satvikg-andrew/AirCube/AirCube_finalized/AirCube_revised/review/JLC3313-user-calculator.png

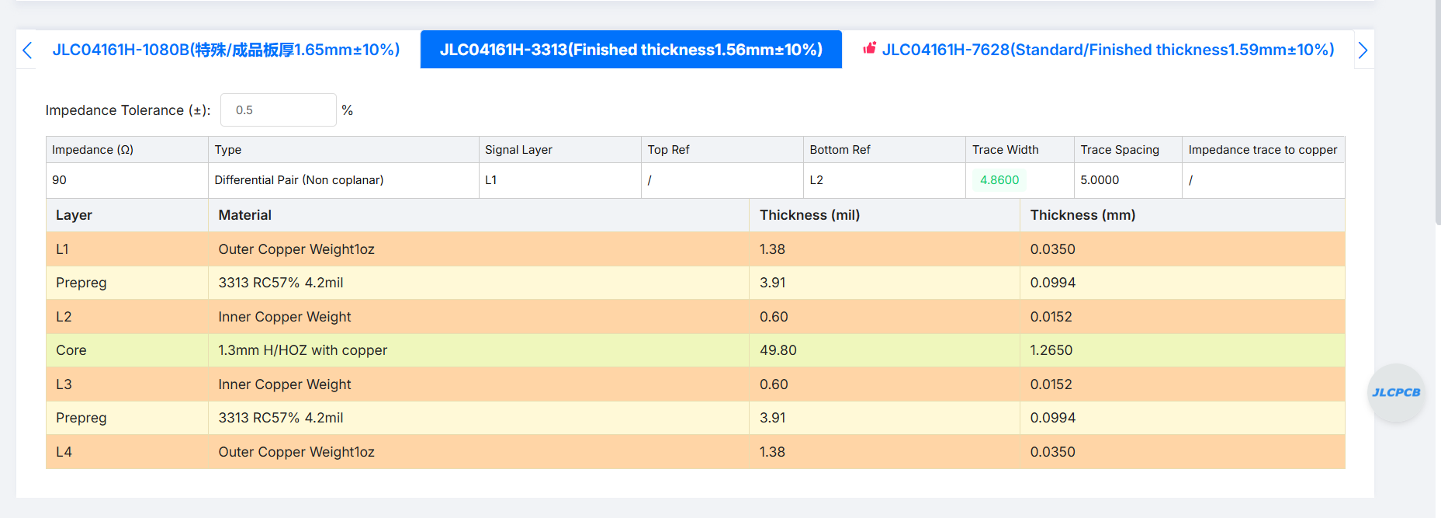
AirCube_finalized/AirCube_revised/review/JLC3313-user-calculator.png
