satvikg-andrew/AirCube/AirCube_finalized/AirCube_revised/review/plots/AirCube-B_Cu.png

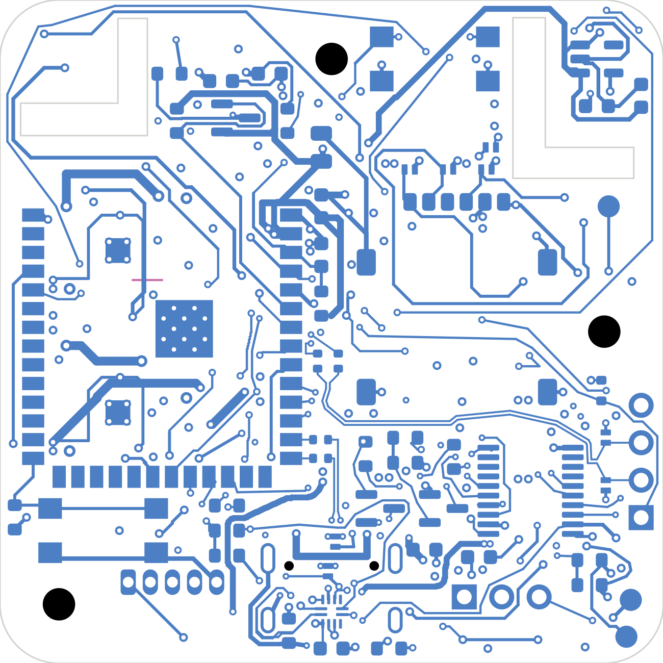
AirCube_finalized/AirCube_revised/review/plots/AirCube-B_Cu.png
