satvikg-andrew/AirCube/AirCube_finalized/AirCube_revised/review/plots/AirCube-F_Cu.png

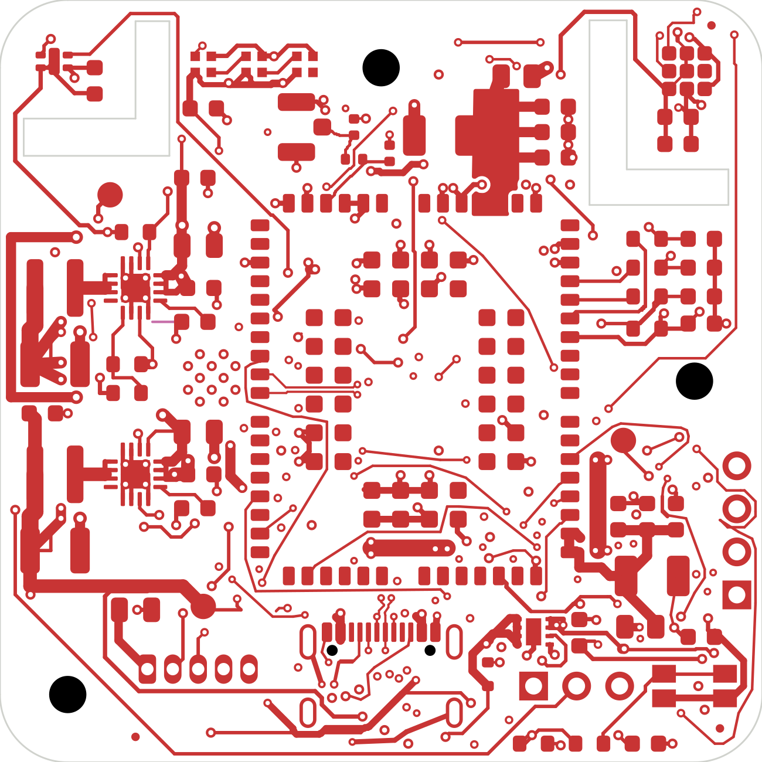
AirCube_finalized/AirCube_revised/review/plots/AirCube-F_Cu.png
