satvikg-andrew/AirCube/AirCube_finalized/AirCube_revised/review/plots/AirCube-In1_Cu.png

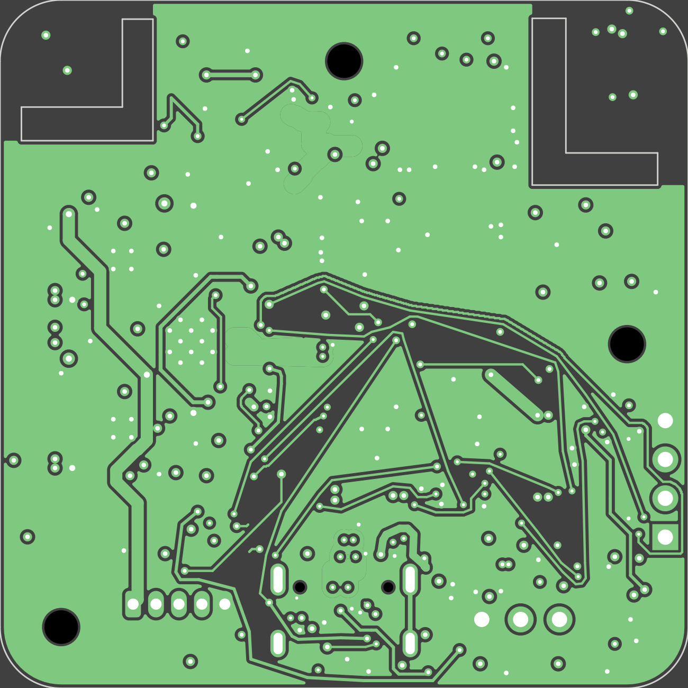
AirCube_finalized/AirCube_revised/review/plots/AirCube-In1_Cu.png
