satvikg-andrew/AirCube/AirCube_finalized/AirCube_revised/review/plots/Gerber-copper-F_Cu.png

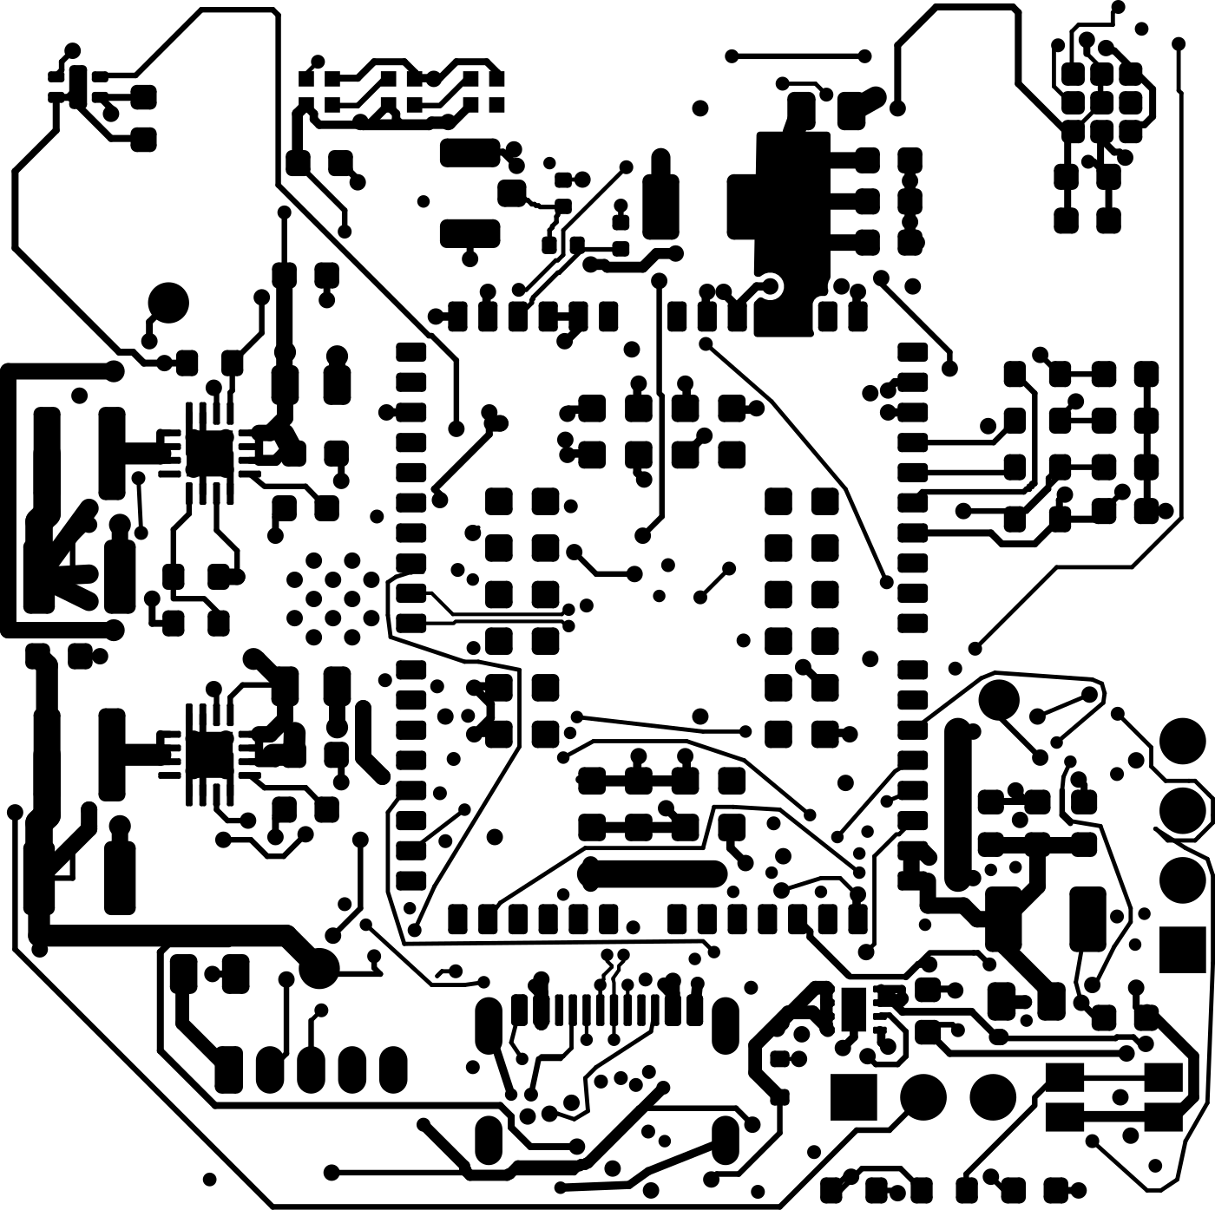
AirCube_finalized/AirCube_revised/review/plots/Gerber-copper-F_Cu.png
