satvikg-andrew/AirCube/kicad/Base/ground-plane-review/inner-ground-preview.png

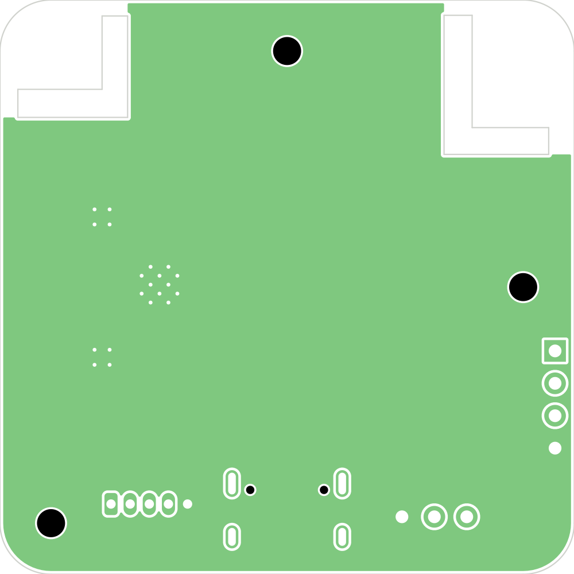
kicad/Base/ground-plane-review/inner-ground-preview.png
