satvikg-andrew/AirCube/kicad/Base/placement-review/placement-overview.png

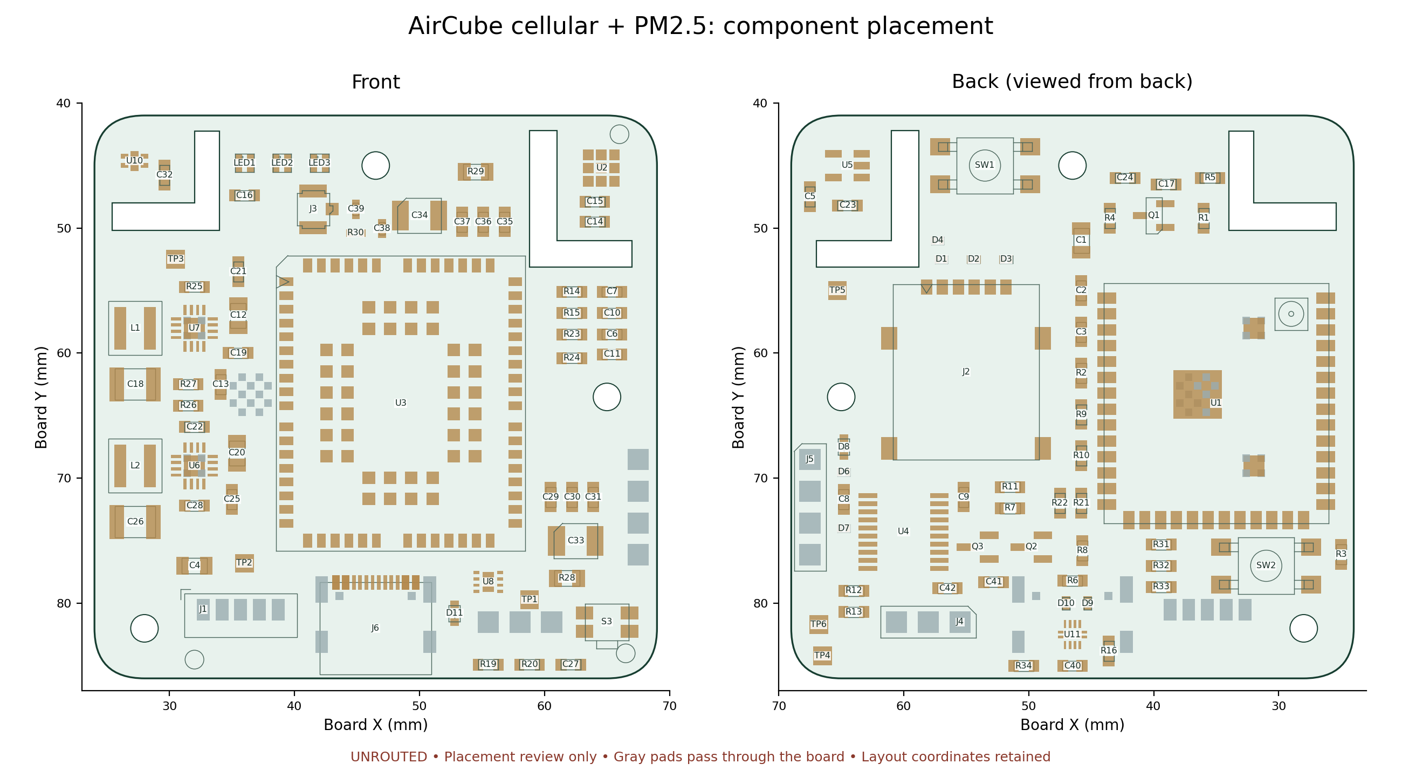
kicad/Base/placement-review/placement-overview.png
