satvikg-andrew/AirCube/kicad/Base/review/previews/back.png

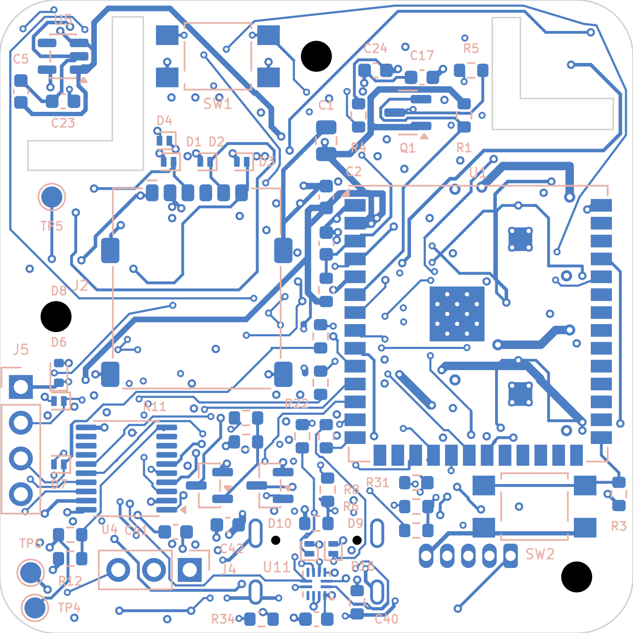
kicad/Base/review/previews/back.png
