satvikg-andrew/AirCube/kicad/Base/review/previews/front.png

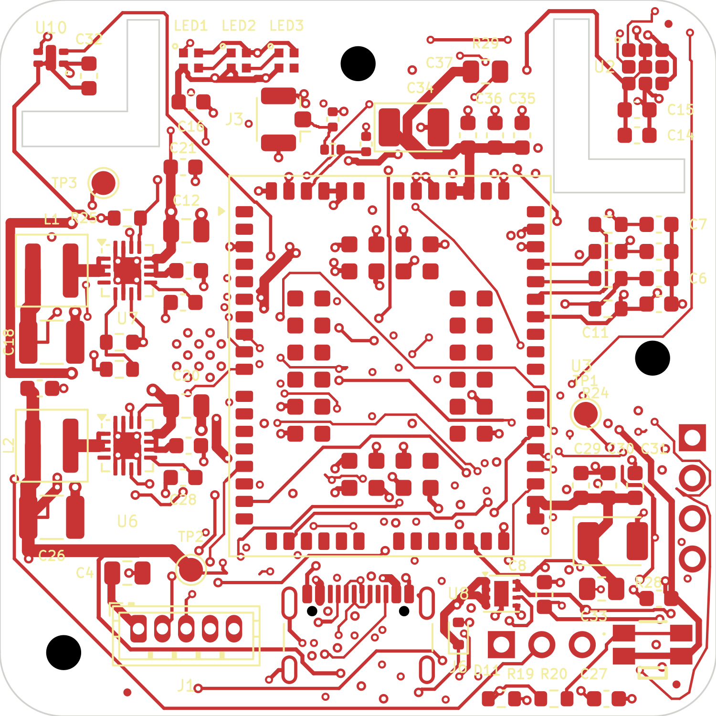
kicad/Base/review/previews/front.png
