satvikg-andrew/AirCube/kicad/Base/review/previews/in1.png

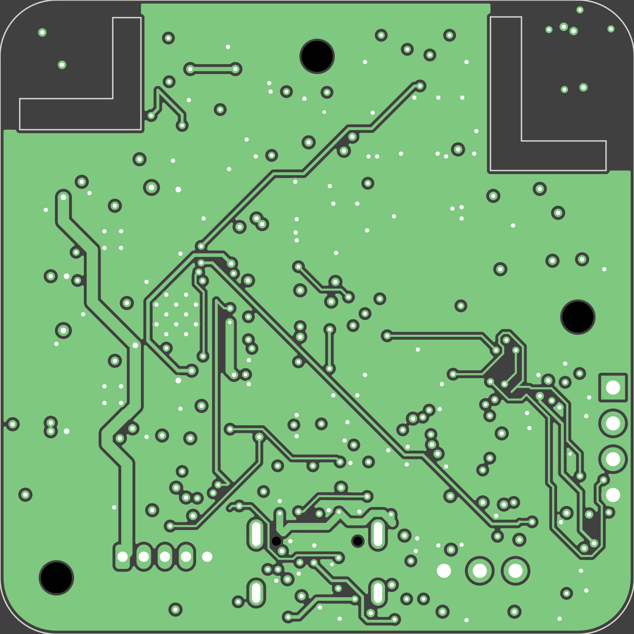
kicad/Base/review/previews/in1.png
