satvikg-andrew/AirCube/kicad/Base/review/previews/in2.png

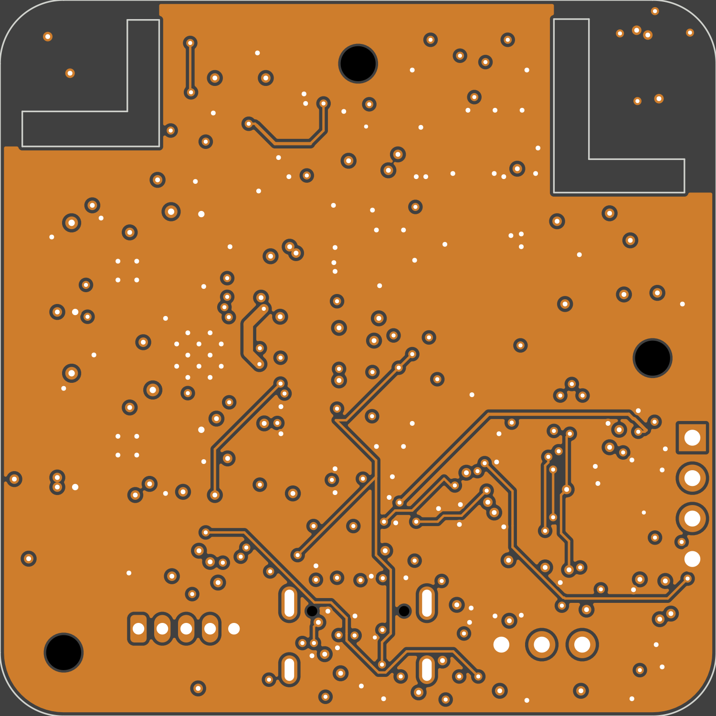
kicad/Base/review/previews/in2.png
