satvikg-andrew/AirCube/kicad/Base/u6-routing-review/u6-copper-preview.png

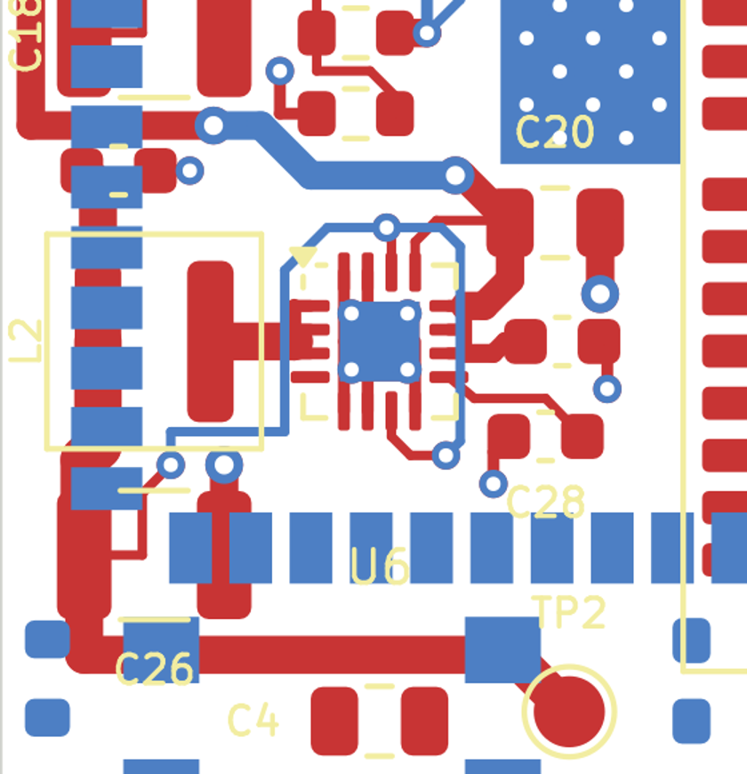
kicad/Base/u6-routing-review/u6-copper-preview.png
