satvikg-andrew/AirCube/kicad/Base/u7-routing-review/u7-copper-preview.png

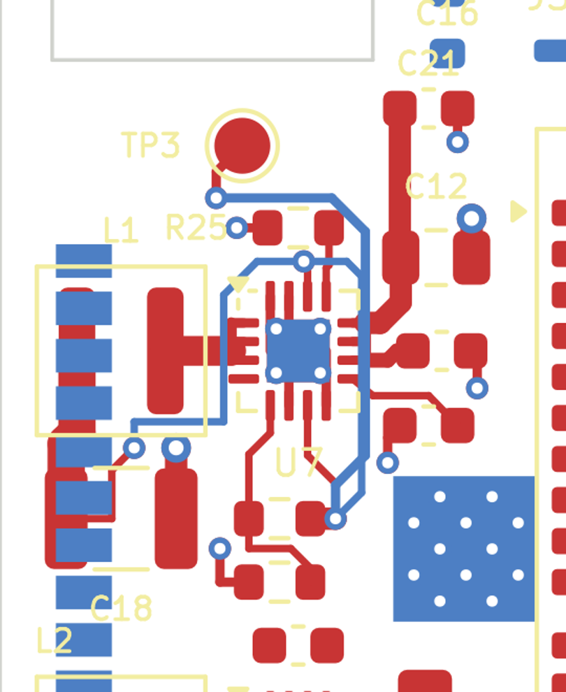
kicad/Base/u7-routing-review/u7-copper-preview.png
