satvikg-andrew/AirCube/(list of files, drawings)

Other design files:
AirCube_finalized/AirCube_revised/review/schematic-erc.json
