satvikg-andrew/AirCube/kicad/Base/AirCube.kicad_pcb

## KiCad design kicad/Base/AirCube.kicad_pcb (2026-10-26)

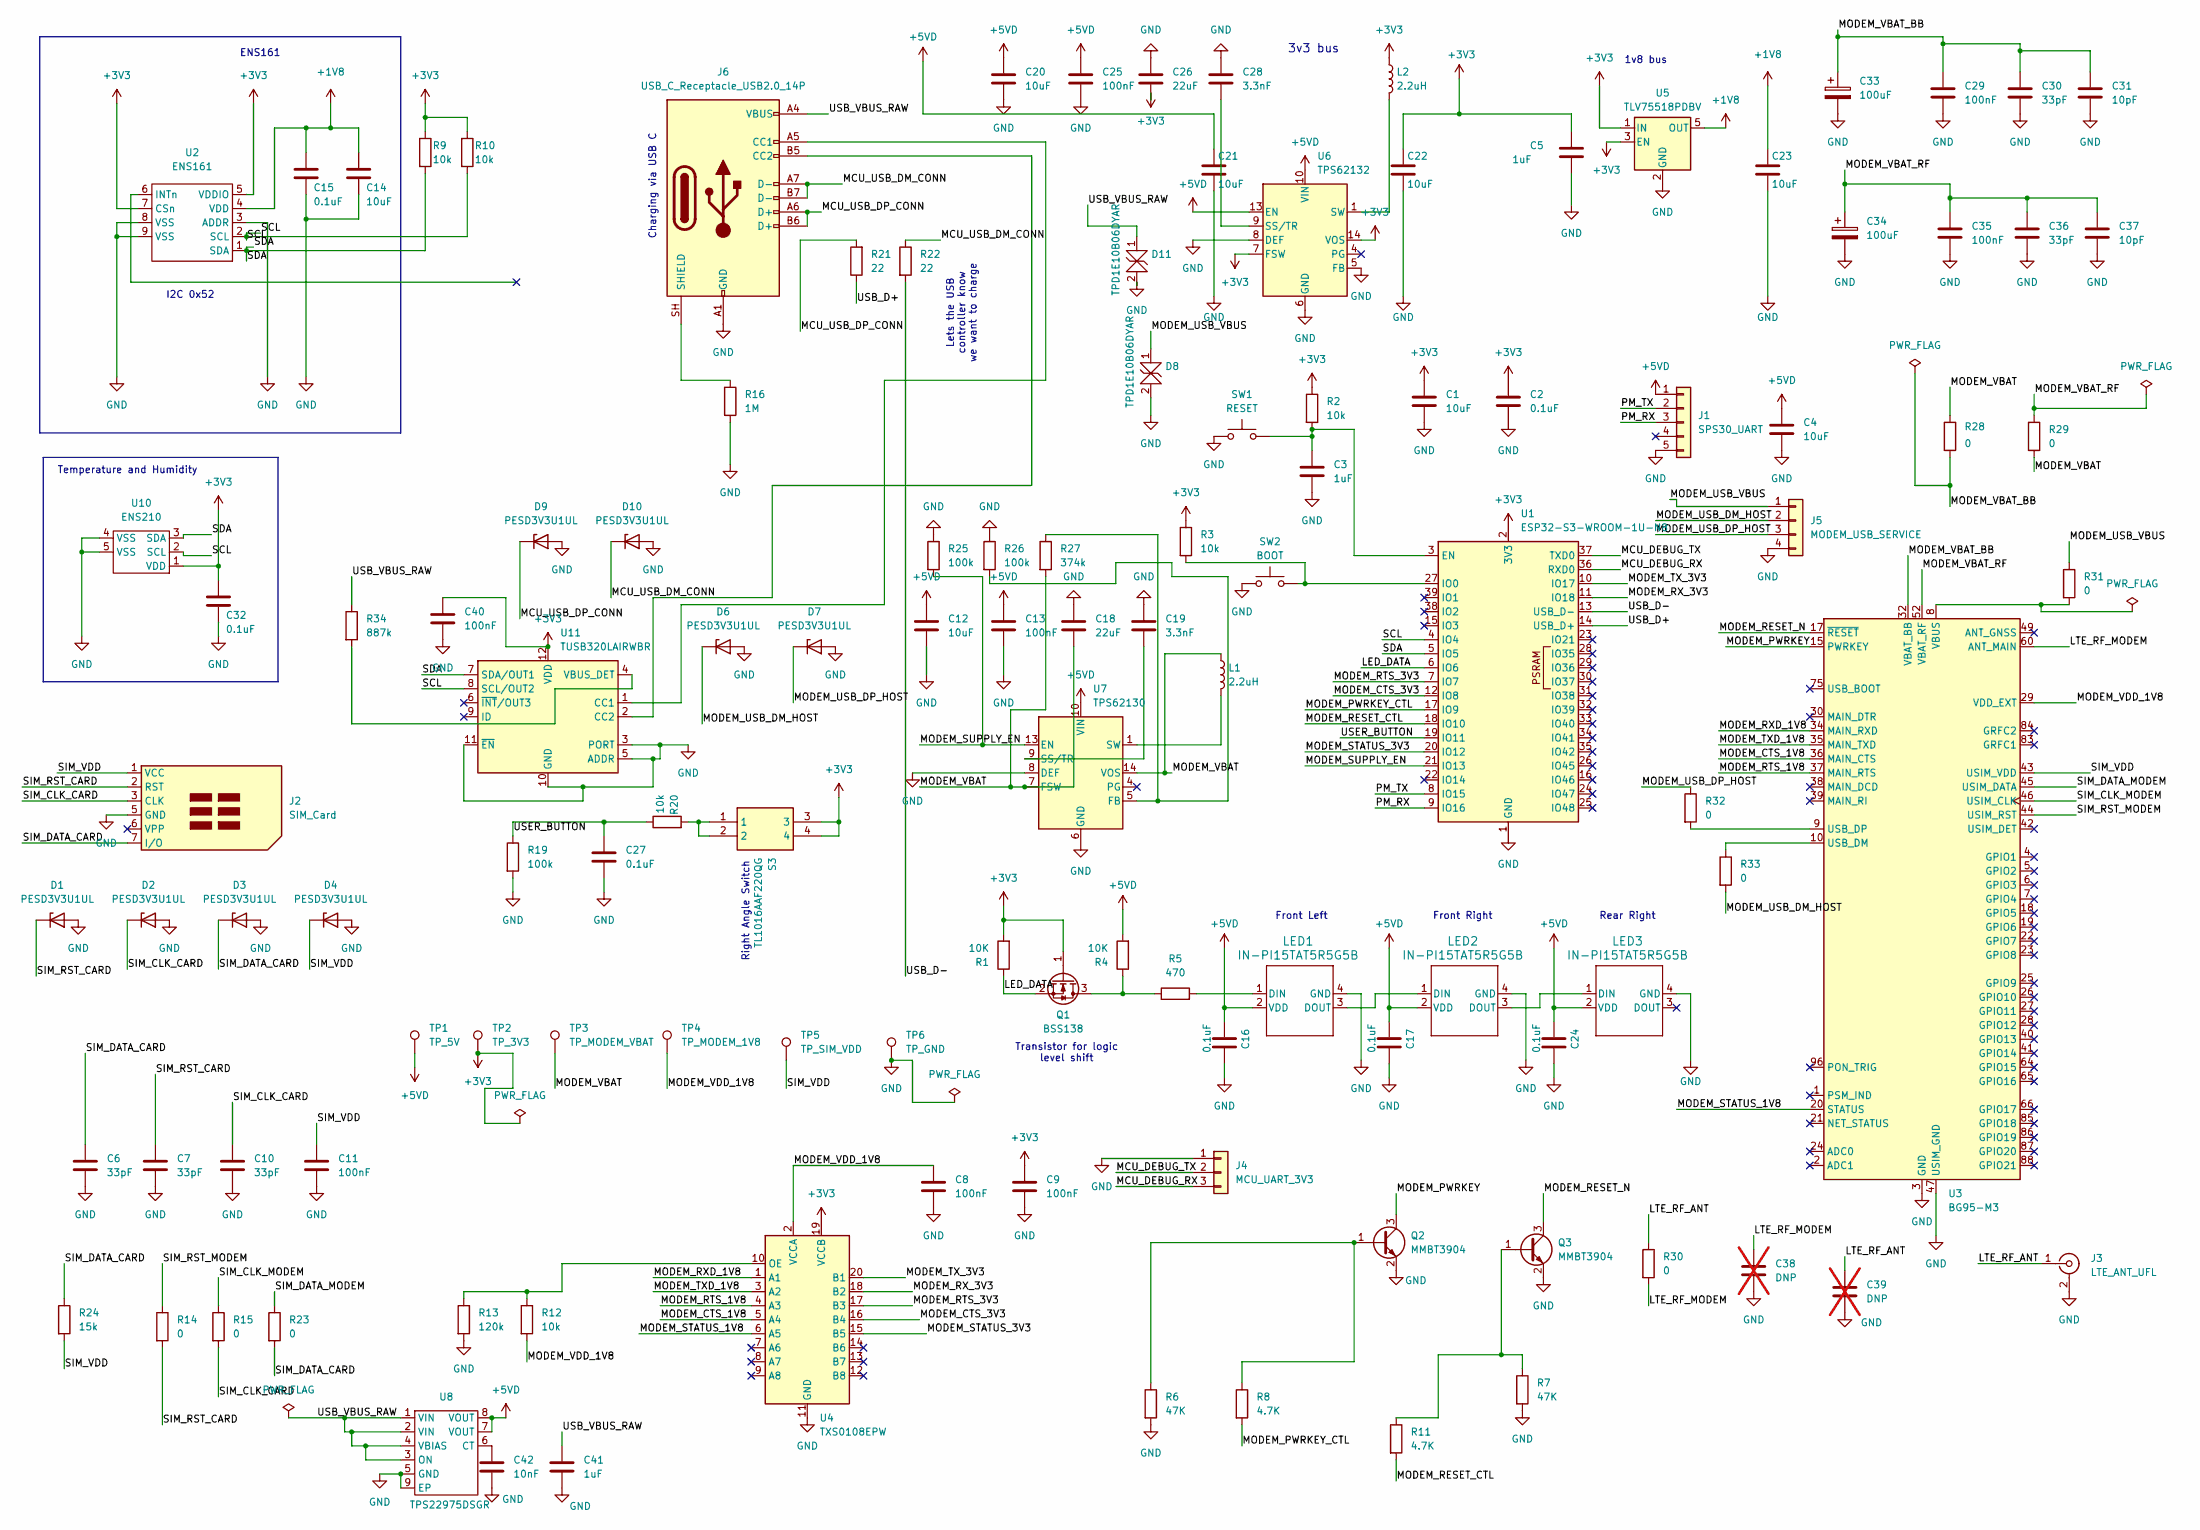
[picture p18: schematic AirCube.kicad_sch]

Parts:
C1, C4, C12, C20: 10uF; C_0805_2012Metric
C2, C15, C16, C17, C24, C27, C32: 0.1uF; C_0603_1608Metric
C3, C5, C41: 1uF; C_0603_1608Metric
C6, C7, C10, C30, C36: 33pF; C_0603_1608Metric
C8, C9, C11, C13, C25, C29, C35, C40: 100nF; C_0603_1608Metric
C14, C21, C22, C23: 10uF; C_0603_1608Metric
C18, C26: 22uF; C_1210_3225Metric
C19, C28: 3.3nF; C_0603_1608Metric
C31, C37: 10pF; C_0603_1608Metric
C33, C34: 100uF; CP_EIA-3528-21_Kemet-B
C38, C39: DNP; C_0402_1005Metric; not fitted
C42: 10nF; C_0603_1608Metric
D1, D2, D3, D4, D6, D7, D9, D10: PESD3V3U1UL; D_SOD-882
D8, D11: TPD1E10B06DYAR; D_SOD-523
J1: SPS30_UART; JST_ZH_B5B-ZR_1x05_P1.50mm_Vertical
J2: SIM_Card; nanoSIM_GCT_SIM8060-6-0-14-00_GroundedShell
J3: LTE_ANT_UFL; U.FL_Hirose_U.FL-R-SMT-1_Vertical
J4: MCU_UART_3V3; PinHeader_1x03_P2.54mm_Vertical
J5: MODEM_USB_SERVICE; PinHeader_1x04_P2.54mm_Vertical
J6: USB_C_Receptacle_USB2.0_14P; USB_C_Receptacle_GCT_USB4105-xx-A_16P_TopMnt_Horizontal
L1, L2: 2.2uH; L_Coilcraft_XAL4020-XXX
LED1, LED2, LED3: IN-PI15TAT5R5G5B; IN-PI15_INL
Q1: BSS138; SOT-23
Q2, Q3: MMBT3904; SOT-23
R1, R4: 10K; R_0603_1608Metric
R2, R3, R9, R10, R12, R20: 10k; R_0603_1608Metric
R5: 470; R_0603_1608Metric
R6, R7: 47K; R_0603_1608Metric
R8, R11: 4.7K; R_0603_1608Metric
R13: 120k; R_0603_1608Metric
R14, R15, R23, R31, R32, R33: 0; R_0603_1608Metric
R16: 1M; R_0603_1608Metric
R19, R25, R26: 100k; R_0603_1608Metric
R21, R22: 22; R_0603_1608Metric
R24: 15k; R_0603_1608Metric
R27: 374k; R_0603_1608Metric
R28, R29: 0; R_0805_2012Metric
R30: 0; R_0402_1005Metric
R34: 887k; R_0603_1608Metric
S3: TL1016AAF220QG; Mouser Part Number 612-TL1016AAF220QG
SW1: RESET; SW_SPST_TL3305A
SW2: BOOT; SW_SPST_TL3305A
TP1: TP_5V; TestPoint_Pad_D1.5mm
TP2: TP_3V3; TestPoint_Pad_D1.5mm
TP3: TP_MODEM_VBAT; TestPoint_Pad_D1.5mm
TP4: TP_MODEM_1V8; TestPoint_Pad_D1.5mm
TP5: TP_SIM_VDD; TestPoint_Pad_D1.5mm
TP6: TP_GND; TestPoint_Pad_D1.5mm
U1: ESP32-S3-WROOM-1U-N8; ESP32-S3-WROOM-1U_ThermalDrill0.30
U2: ENS161
U3: BG95-M3; Quectel_BG95
U4: TXS0108EPW; TSSOP-20_4.4x6.5mm_P0.65mm
U5: TLV75518PDBV; SOT-23-5
U6: TPS62132; TPS6213x_RGT_ThermalDrill0.30
U7: TPS62130; TPS6213x_RGT_ThermalDrill0.30
U8: TPS22975DSGR; TPS22975_DSG_TI_LandPattern
U10: ENS210
U11: TUSB320LAIRWBR; Texas_X2QFN-12_1.6x1.6mm_P0.4mm

Connections:
+1V8: C14.1, C15.1, C23.1, U2.4 (VDD), U5.5 (OUT)
+3V3: C1.1, C2.1, C5.1, C9.1, C22.1, C26.2, C32.1, C40.1, L2.1, Q1.1 (G), R1.2, R2.1, R3.1, R9.1, R10.1, S3.3, S3.4, TP2.1 (1_1), U1.2 (3V3), U2.5 (VDDIO), U2.7 (CSn), U4.19 (VCCB), U5.1 (IN), U5.3 (EN), U6.7 (FSW), U6.14 (VOS), U10.1 (VDD), U11.12 (VDD)
+5VD: C4.1, C12.1, C13.1, C16.1, C17.1, C20.1, C21.1, C24.1, C25.1, J1.1, LED1.2 (VDD), LED2.2 (VDD), LED3.2 (VDD), R4.2, TP1.1 (1_1), U6.10 (VIN), U6.11 (VIN), U6.12 (VIN), U6.13 (EN), U7.10 (VIN), U7.11 (VIN), U7.12 (VIN), U8.7 (VOUT), U8.8 (VOUT)
/LED_DATA: Q1.2 (S), R1.1, U1.6 (IO6)
/LTE_RF_ANT: C39.1, J3.1 (In), R30.1
/LTE_RF_MODEM: C38.1, R30.2, U3.60 (ANT_MAIN)
/MCU_DEBUG_RX: J4.3, U1.36 (RXD0)
/MCU_DEBUG_TX: J4.2, U1.37 (TXD0)
/MCU_USB_DM_CONN: D10.1 (K), J6.A7 (D-), J6.B7 (D-), R22.1
/MCU_USB_DP_CONN: D9.1 (K), J6.A6 (D+), J6.B6 (D+), R21.2
/MODEM_CTS_1V8: U3.36 (MAIN_CTS), U4.5 (A4)
/MODEM_CTS_3V3: U1.12 (IO8), U4.16 (B4)
/MODEM_PWRKEY: Q2.3 (C), U3.15 (PWRKEY)
/MODEM_PWRKEY_CTL: R8.2, U1.17 (IO9)
/MODEM_RESET_CTL: R11.2, U1.18 (IO10)
/MODEM_RESET_N: Q3.3 (C), U3.17 (~RESET)
/MODEM_RTS_1V8: U3.37 (MAIN_RTS), U4.4 (A3)
/MODEM_RTS_3V3: U1.7 (IO7), U4.17 (B3)
/MODEM_RXD_1V8: U3.34 (MAIN_RXD), U4.1 (A1)
/MODEM_RX_3V3: U1.11 (IO18), U4.18 (B2)
/MODEM_STATUS_1V8: U3.20 (STATUS), U4.6 (A5)
/MODEM_STATUS_3V3: U1.20 (IO12), U4.15 (B5)
/MODEM_SUPPLY_EN: R25.2, U1.21 (IO13), U7.13 (EN)
/MODEM_TXD_1V8: U3.35 (MAIN_TXD), U4.3 (A2)
/MODEM_TX_3V3: U1.10 (IO17), U4.20 (B1)
/MODEM_USB_DM_HOST: D6.1 (K), J5.2, R33.2
/MODEM_USB_DP_HOST: D7.1 (K), J5.3, R32.1
/MODEM_USB_VBUS: D8.1, J5.1, R31.1
/MODEM_VBAT: C18.2, L1.1, R27.2, R28.1, R29.2, TP3.1 (1_1), U7.7 (FSW), U7.14 (VOS)
/MODEM_VBAT_BB: C29.1, C30.1, C31.1, C33.1, R28.2, U3.32 (VBAT_BB), U3.33 (VBAT_BB)
/MODEM_VBAT_RF: C34.1, C35.1, C36.1, C37.1, R29.1, U3.52 (VBAT_RF), U3.53 (VBAT_RF)
/MODEM_VDD_1V8: C8.1, R12.2, TP4.1 (1_1), U3.29 (VDD_EXT), U4.2 (VCCA)
/PM_RX: J1.3, U1.9 (IO16)
/PM_TX: J1.2, U1.8 (IO15)
/SCL: R10.2, U1.4 (IO4), U2.2 (SCL), U10.2 (SCL), U11.8 (SCL/OUT2)
/SDA: R9.2, U1.5 (IO5), U2.1 (SDA), U10.3 (SDA), U11.7 (SDA/OUT1)
/SIM_CLK_CARD: C10.1, D2.1 (K), J2.3 (CLK), R15.2
/SIM_CLK_MODEM: R15.1, U3.46 (USIM_CLK)
/SIM_DATA_CARD: C6.1, D3.1 (K), J2.7 (I/O), R23.2, R24.1
/SIM_DATA_MODEM: R23.1, U3.45 (USIM_DATA)
/SIM_RST_CARD: C7.1, D1.1 (K), J2.2 (RST), R14.2
/SIM_RST_MODEM: R14.1, U3.44 (USIM_RST)
/SIM_VDD: C11.1, D4.1 (K), J2.1 (VCC), R24.2, TP5.1 (1_1), U3.43 (USIM_VDD)
/USB_D+: R21.1, U1.14 (USB_D+)
/USB_D-: R22.2, U1.13 (USB_D-)
/USB_VBUS_RAW: C41.1, D11.1, J6.A4 (VBUS), J6.A9 (VBUS), J6.B4 (VBUS), J6.B9 (VBUS), R34.1, U8.1 (VIN), U8.2 (VIN), U8.3 (ON), U8.4 (VBIAS)
/USER_BUTTON: C27.1, R19.1, R20.1, U1.19 (IO11)
GND: C1.2, C2.2, C3.2, C4.2, C5.2, C6.2, C7.2, C8.2, C9.2, C10.2, C11.2, C12.2, C13.2, C14.2, C15.2, C16.2, C17.2, C18.1, C19.1, C20.2, C21.2, C22.2, C23.2, C24.2, C25.2, C26.1, C27.2, C28.1, C29.2, C30.2, C31.2, C32.2, C33.2, C34.2, C35.2, C36.2, C37.2, C38.2, C39.2, C40.2, C41.2, C42.2, D1.2 (A), D2.2 (A), D3.2 (A), D4.2 (A), D6.2 (A), D7.2 (A), D8.2, D9.2 (A), D10.2 (A), D11.2, J1.5, J2.5 (GND), J3.2 (Ext), J4.1, J5.4, J6.A1 (GND), J6.A12 (GND), J6.B1 (GND), J6.B12 (GND), LED1.4 (GND), LED2.4 (GND), LED3.4 (GND), Q2.2 (E), Q3.2 (E), R6.2, R7.2, R13.2, R16.2, R19.2, R25.1, R26.1, SW1.1, SW2.1, TP6.1 (1_1), U1.1 (GND), U1.40 (GND), U1.41 (GND), U2.3 (ADDR), U2.8 (VSS), U2.9 (VSS), U3.3 (GND), U3.31 (GND), U3.47 (USIM_GND), U3.48 (GND), U3.50 (GND), U3.54 (GND), U3.55 (GND), U3.58 (GND), U3.59 (GND), U3.61 (GND), U3.62 (GND), U3.67 (GND), U3.68 (GND), U3.69 (GND), U3.70 (GND), U3.71 (GND), U3.72 (GND), U3.73 (GND), U3.74 (GND), U3.79 (GND), U3.80 (GND), U3.81 (GND), U3.82 (GND), U3.89 (GND), U3.90 (GND), U3.91 (GND), U3.100 (GND), U3.101 (GND), U3.102 (GND), U4.11 (GND), U5.2 (GND), U6.5 (FB), U6.6 (GND), U6.8 (DEF), U6.15 (GND), U6.16 (GND), U6.17 (GND), U7.6 (GND), U7.8 (DEF), U7.15 (GND), U7.16 (GND), U7.17 (GND), U8.5 (GND), U8.9 (EP), U10.4 (VSS), U10.5 (VSS), U11.3 (PORT), U11.5 (ADDR), U11.10 (GND), U11.11 (~EN)
unnamed: J6.A5 (CC1), U11.1 (CC1)
unnamed: J6.B5 (CC2), U11.2 (CC2)
unnamed: J6.SH (SHIELD), R16.1
unnamed: L1.2, U7.1 (SW), U7.2 (SW), U7.3 (SW)
unnamed: L2.2, U6.1 (SW), U6.2 (SW), U6.3 (SW)
unnamed: LED1.1 (DIN), R5.2
unnamed: LED1.3 (DOUT), LED2.1 (DIN)
unnamed: LED2.3 (DOUT), LED3.1 (DIN)
unnamed: Q1.3 (D), R4.1, R5.1
unnamed: Q2.1 (B), R6.1, R8.1
unnamed: Q3.1 (B), R7.1, R11.1
unnamed: R20.2, S3.1, S3.2
unnamed: C3.1, R2.2, SW1.2, U1.3 (EN)
unnamed: R3.2, SW2.2, U1.27 (IO0)
unnamed: R33.1, U3.10 (USB_DM)
unnamed: R32.2, U3.9 (USB_DP)
unnamed: R31.2, U3.8 (VBUS)
unnamed: R12.1, R13.1, U4.10 (OE)
unnamed: C28.2, U6.9 (SS/TR)
unnamed: R26.2, R27.1, U7.5 (FB)
unnamed: C19.2, U7.9 (SS/TR)
unnamed: C42.1, U8.6 (CT)
unnamed: R34.2, U11.4 (VBUS_DET)

Notes on the sheet:
Charging via USB C
Rear Right
Transistor for logic level shift
1v8 bus
Right Angle Switch
Lets the USB controller know we want to charge
Front Right
ENS161
3v3 bus
Front Left
I2C 0x52
Temperature and Humidity

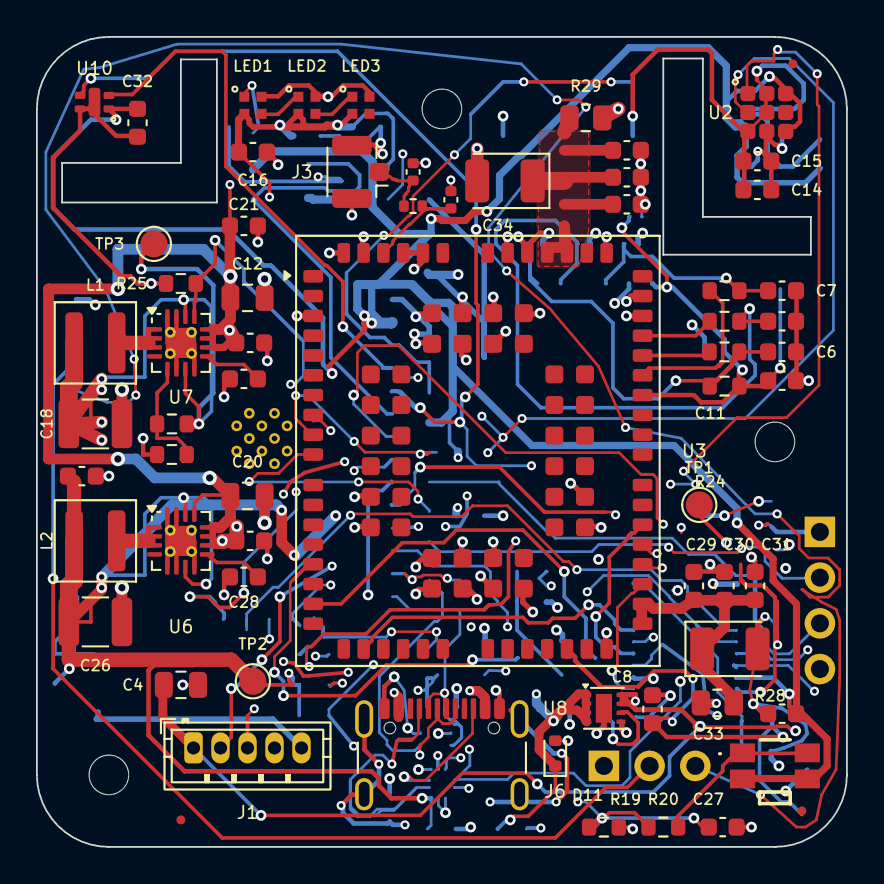
[picture p19: board AirCube.kicad_pcb from above]

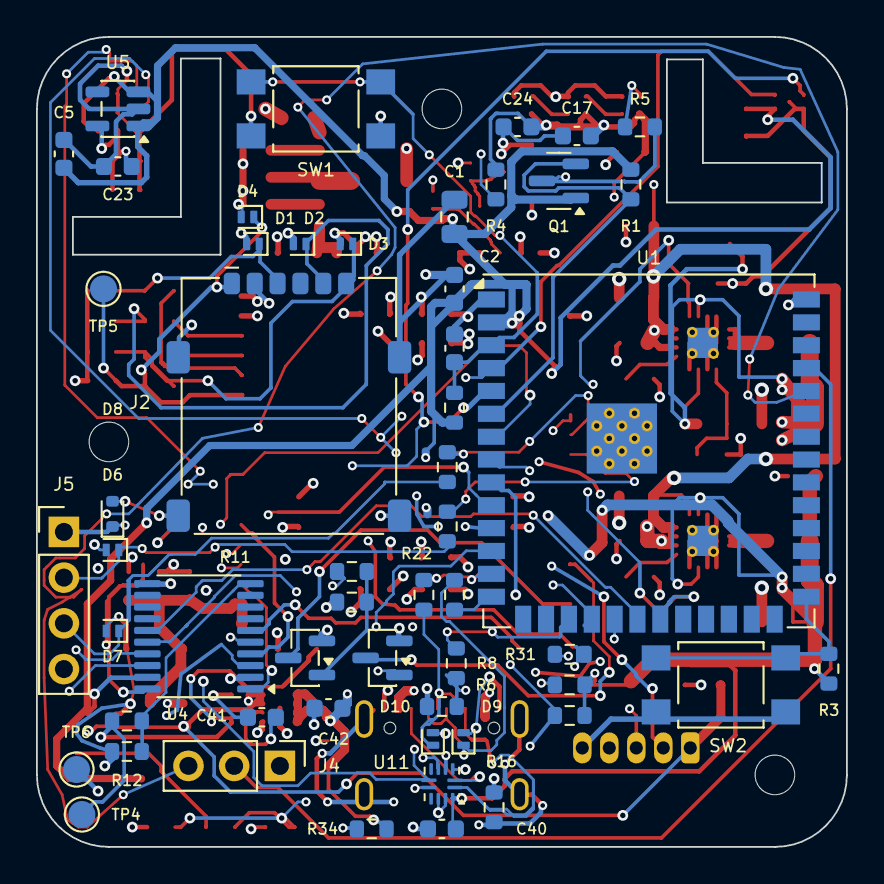
[picture p20: board AirCube.kicad_pcb from below]

Board: 4 copper layers, 45.0 x 45.0 mm, 117 parts (54 on the bottom side), 71 nets.
