satvikg-andrew/AirCube/(commit log)

2026-10-24 Recover original PCB footprints into project-local library
2026-10-24 Replace H2 schematic with S3 and add PM UART and modem control nets
    [AirCube.kicad_sch]
2026-10-24 Assign connector footprints and ground nano-SIM shell pads
    [AirCube.kicad_sch]
2026-10-25 Add cellular and particulate sensor circuitry and project libraries
    [AirCube.kicad_sch]
2026-10-25 Save symbol library table as UTF-8 without BOM
2026-10-25 Route local power stages and join regulator inputs
    [AirCube.kicad_pcb, AirCube.kicad_sch]
2026-10-26 Checkpoint cellular and PM2.5 design before manufacturer-specific routing
    [AirCube-before-placement.kicad_pcb, AirCube.kicad_pcb]
2026-10-26 got routing with 0 errors; some power errors visible
    [AirCube.kicad_pcb]
2026-10-26 Finalize AirCube hardware and manufacturing package for fabrication review
    [AirCube-B_Cu.gbl, AirCube-B_Mask.gbs, AirCube-B_Paste.gbp, AirCube-B_Silkscreen.gbo, AirCube-Edge_Cuts.gm1, AirCube-F_Cu.gtl, AirCube-F_Mask.gts, AirCube-F_Paste.gtp]
